anialopata/SMIW/Hardware/plytka.png

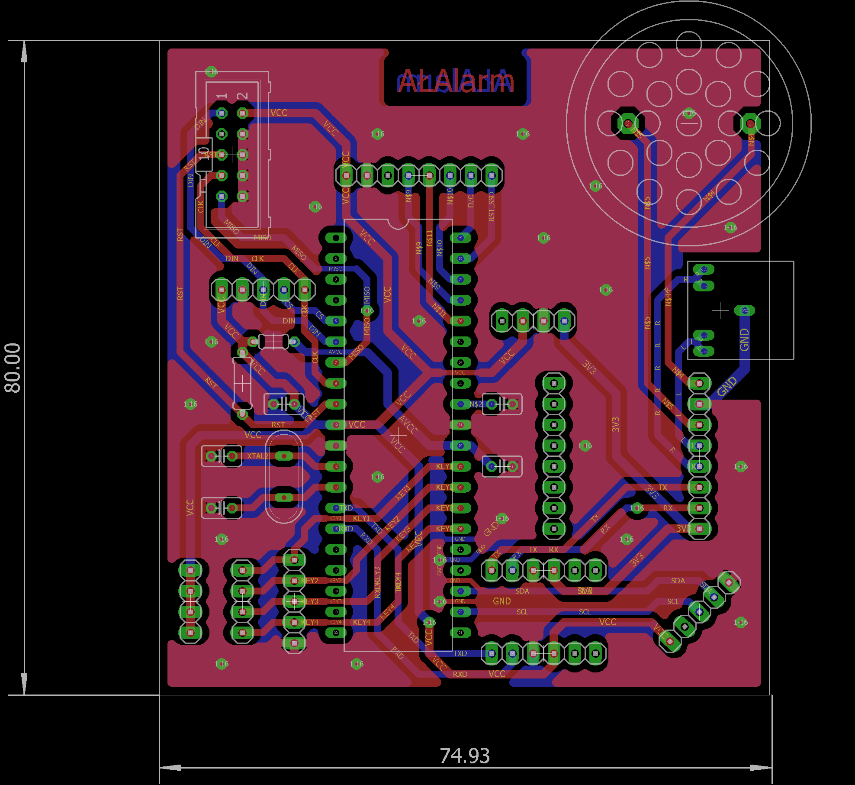
Hardware/plytka.png
