anialopata/SMIW/Hardware/schemat.png

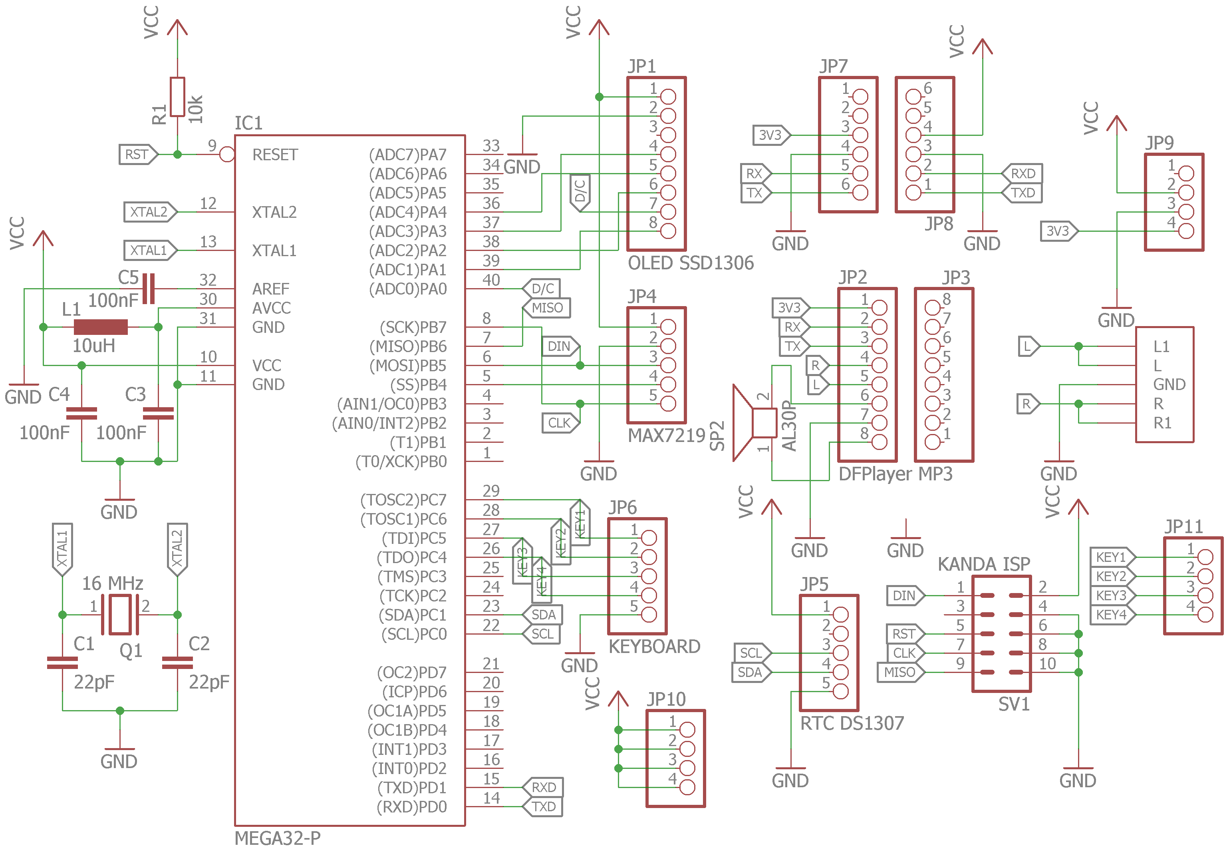
Hardware/schemat.png
