anialopata/SMIW/Utility/kosztorysrev1.xlsx

No | Reference | Description | Price Netto PLN | Qty | Link | Type | Tip
1 | JP2, JP3 | DFPlayer mini odtwarzacz MP3 z gniazdem microSD | 25.12 zł | 1 | https://botland.com.pl/odtwarzacze-mp3-wav-oog-midi/3170-dfplayer-mini-odtwarzacz-mp3-z-gniazdem-microsd.html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 | sterowanie | https://www.dfrobot.com/wiki/index.php/DFPlayer_Mini_SKU:DFR0299#Connection_Diagram
2 | JP1 | Wyświetlacz OLED dwukolorowy graficzny 0,96'' (B) 128x64px SPI/I2C- proste złącza | 28.37 zł | 1 | https://botland.com.pl/wyswietlacze-oled/4437-wyswietlacz-oled-dwukolorowy-graficzny-096-b-128x64px-spii2c-proste-zlacza.html |  | https://github.com/efthymios-ks/AVR-SSD1306-Library
3 | - | Karta pamięci Goodram M1AA microSD 8GB 60MB/s UHS-I klasa 10 z adapterem | 20.28 zł | 1 | https://botland.com.pl/karty-pamieci-microsd-sd/2122-karta-pamieci-goodram-m1aa-microsd-8gb-60mbs-uhs-i-klasa-10-z-adapterem-5908267913277.html
4 | JP5 | MSX RTC DS1307 I2C - zegar czasu rzeczywistego + bateria | 14.55 zł | 1 | https://botland.com.pl/moduly-rtc/2717-msx-rtc-ds1307-i2c-zegar-czasu-rzeczywistego-bateria.html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 |  | http://www.jarzebski.pl/arduino/komponenty/zegar-czasu-rzeczywistego-rtc-ds1307.html
5 | SP1 | Głośnik YD30 0,5W 8Ohm - 15 x 12 mm | 1.95 zł | 1 | https://botland.com.pl/glosniki-analogowe/3469-glosnik-yd30-05w-8ohm-15-x-12-mm.html
6 | JP6 | Klawiatura numeryczna membranowa samoprzylepna - 4 klawisze | 5.28 zł | 1 | https://botland.com.pl/klawiatury/4266-klawiatura-numeryczna-membranowa-samoprzylepna-4-klawisze.html |  | https://botland.com.pl/img/p/3/4/7/6/5/34765.jpg?time=1501065470757
7 | JP4 | Matryca LED 32x8 + sterownik MAX7219 - czerwony | 26.61 zł | 1 | http://allegro.pl/modul-4-matryce-led-8x8-ze-sterownikiem-max7219-i7281989137.html |  | https://adnbr.co.uk/articles/max7219-and-7-segment-displays
8 | IC1 | Mikrokontroler AVR - ATmega32A-PU - DIP | 10.49 zł | 1 | https://botland.com.pl/avr-tht-dip/159-mikrokontroler-avr-atmega32a-pu-dip.html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
9 | Q1 | Rezonator kwarcowy 16MHz - HC49 - niski | 0.57 zł | 1 | https://botland.com.pl/rezonatory/166-rezonator-kwarcowy-16mhz-hc49-niski.html?search_query=kwarc&results=54 | pasywne | http://mikrokontrolery.blogspot.com/2011/04/minimalne-podlaczanie-pinow.html
10 | C3, C4, C5 | Kondensator ceramiczny 100nF/50V THT - 10szt. | 0.80 zł | 1 | https://botland.com.pl/kondensatory-ceramiczne-dip/210-kondensator-ceramiczny-100nf50v-tht-10szt.html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
11 | R1 | Rezystor THT 1/4 W 10kΩ - 30szt. | 1.54 zł | 1 | https://botland.com.pl/rezystory-przewlekane/3967-rezystor-tht-14-w-10k-30-szt.html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
12 | SV1 | Wtyk IDC 10 pin prosty - 5 szt. | 1.63 zł | 1 | https://botland.com.pl/zlacza-idc/191-wtyk-idc-10pin-prosty-5-szt.html?search_query=idc&results=74
13 | L1 | Dławik osiowy przeciwzakłóceniowy 10uH/160mA - 10szt. | 1.63 zł | 1 | https://botland.com.pl/dlawiki/438-dlawik-osiowy-przeciwzakloceniowy-10uh-10szt.html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
14 | C1, C2 | Kondensator ceramiczny 22pF/50V THT - 10 szt. | 0.80 zł | 1 | https://botland.com.pl/kondensatory-ceramiczne-dip/448-kondensator-ceramiczny-22pf50v-tht-10szt.html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
15 | - | Płytka stykowa 830 otworów | 6.42 zł | 1 | https://botland.com.pl/plytki-stykowe/55-plytka-stykowa-830-otworow.html | prototyp
16 | - | Przewody połączeniowe męsko-męskie 20cm - 40szt. | 4.84 zł | 1 | https://botland.com.pl/przewody-polaczeniowe/1223-przewody-polaczeniowe-mesko-meskie-20cm-40szt.html
17 | - | Przejściówka kanda ISP 6 PIN - ISP 10 PIN | 3.98 zł | 1 | https://botland.com.pl/programatory/1688-przejsciowka-kanda-isp-6-pin-isp-10-pin.html |  | https://www.google.pl/search?q=kanda+isp&tbm=isch&biw=1680&bih=944
18 | - | Programator USB AVR Pololu v2 - microUSB 3,3V/5V | 35.77 zł | 1 | https://botland.com.pl/programatory/5720-programator-avr-2-zgodny-z-usbasp-isp.html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 |  | https://www.pololu.com/product/3170 | podłączany przez przejściówkę (16) do SV1 w celu programowania układu
19 | - | Drukowanie płytki PCB | 26.09 zł | 1 | http://fabrykapcb.pl/kalkulator.html | usługi
 |  |  |  | 216.73 zł
