anialopata/SMIW/Utility/Logic_level_converter.pdf

A

A

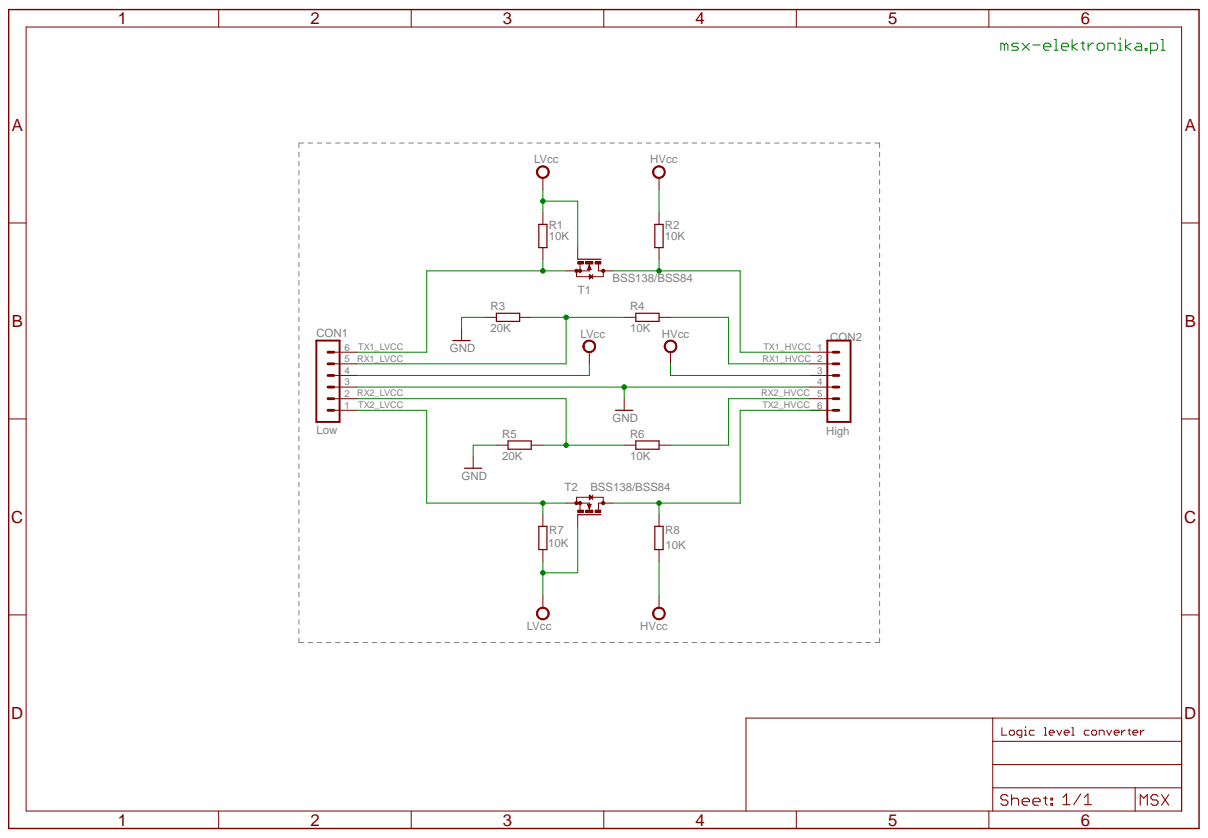
[picture p3: page 1]
