anialopata/SMIW/Hardware/plytka.brd

## EAGLE design Hardware/plytka.brd (2018-09-09)

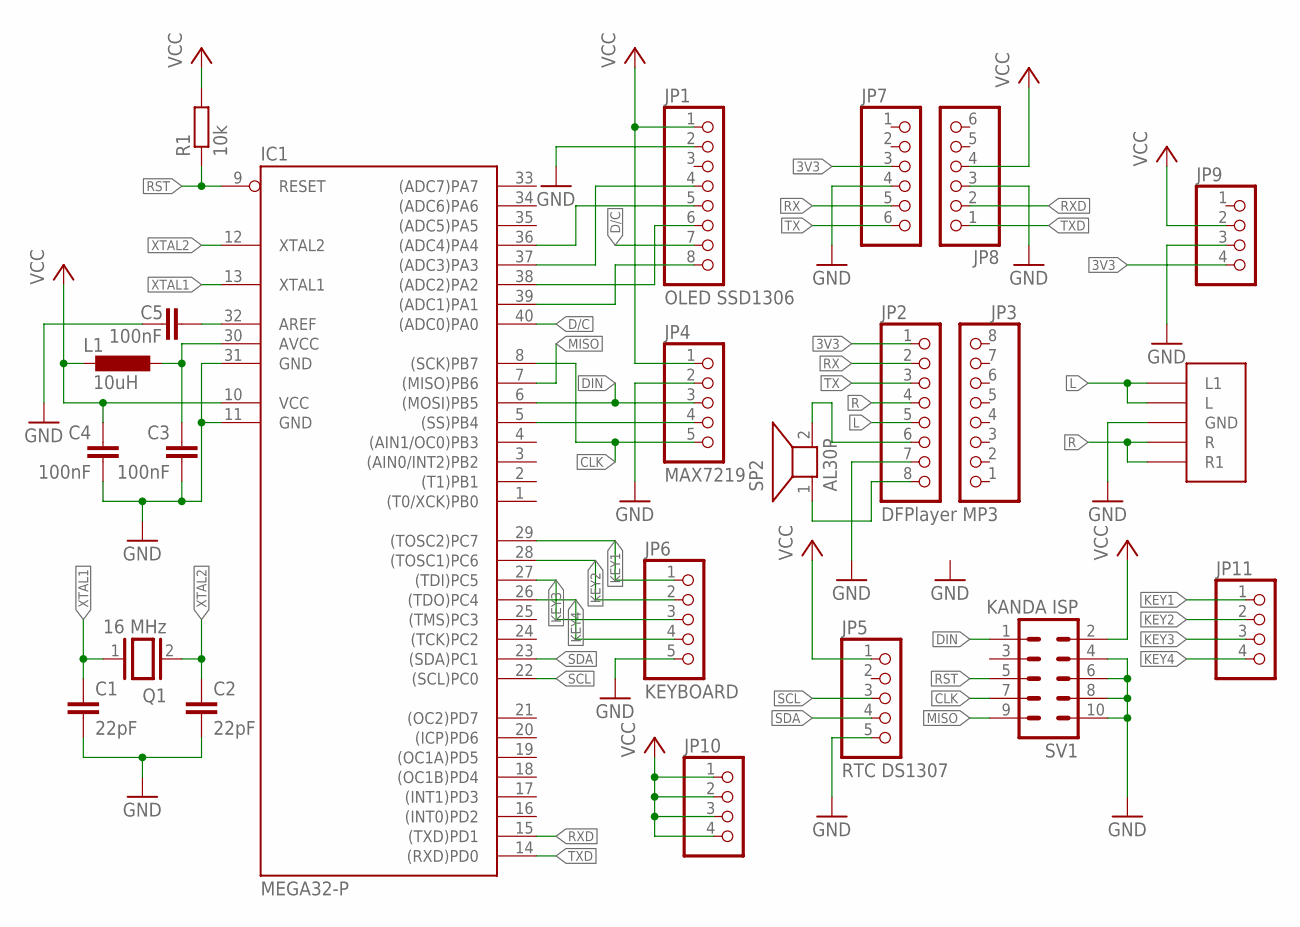
[picture p4: schematic schemat.sch]

Parts:
C1, C2: 22pF; C025-025X050
C3, C4, C5: 100nF; C025-025X050
IC1: MEGA32-P; DIL40
JP1: OLED SSD1306; 1X08
JP2: DFPlayer MP3; 1X08
JP3: 1X08
JP4: MAX7219; 1X05
JP5: RTC DS1307; 1X05
JP6: KEYBOARD; 1X05
JP7, JP8: PINHD-1X6; 1X06
JP9, JP10, JP11: PINHD-1X4; 1X04
L1: 10uH; 0204/5
Q1: 16 MHz; QS
R1: 10k; 0207/7
SP2: AL30P
SV1: KANDA ISP; ML10
U$1: STEREO_D; STEREO_P

Connections:
3V3: JP2.1, JP7.3, JP9.4
AVCC: C3.1, IC1.30 (AVCC), L1.1
CLK: IC1.8 ((SCK)PB7), JP4.5, SV1.7
CS: IC1.5 ((SS)PB4), JP4.4
D/C: IC1.40 ((ADC0)PA0), JP1.7
DIN: IC1.6 ((MOSI)PB5), JP4.3, SV1.1
GND: C1.2, C2.2, C3.2, C4.2, C5.2, IC1.11 (GND), IC1.31 (GND), JP1.2, JP2.7, JP4.2, JP5.5, JP6.5, JP7.4, JP8.3, JP9.3, SV1.4, SV1.6, SV1.8, SV1.10, U$1.GND
KEY1: IC1.29 ((TOSC2)PC7), JP6.1, JP11.1
KEY2: IC1.28 ((TOSC1)PC6), JP6.2, JP11.2
KEY3: IC1.27 ((TDI)PC5), JP6.3, JP11.3
KEY4: IC1.26 ((TDO)PC4), JP6.4, JP11.4
L: JP2.5, U$1.L_A (L1), U$1.L_B (L)
MISO: IC1.7 ((MISO)PB6), SV1.9
unnamed: C5.1, IC1.32 (AREF)
unnamed: JP2.8, SP2.1
unnamed: JP2.6, SP2.2
unnamed: IC1.37 ((ADC3)PA3), JP1.4
unnamed: IC1.38 ((ADC2)PA2), JP1.6
unnamed: IC1.36 ((ADC4)PA4), JP1.5
R: JP2.4, U$1.R_A (R1), U$1.R_B (R)
RST: IC1.9 (RESET), R1.1, SV1.5
RST_SSD: IC1.39 ((ADC1)PA1), JP1.8
RX: JP2.2, JP7.5
RXD: IC1.15 ((TXD)PD1), JP8.2
SCL: IC1.22 ((SCL)PC0), JP5.3
SDA: IC1.23 ((SDA)PC1), JP5.4
TX: JP2.3, JP7.6
TXD: IC1.14 ((RXD)PD0), JP8.1
VCC: C4.1, IC1.10 (VCC), JP1.1, JP4.1, JP5.1, JP8.4, JP9.2, JP10.1, JP10.2, JP10.3, JP10.4, L1.2, R1.2, SV1.2
XTAL1: C1.1, IC1.13 (XTAL1), Q1.1
XTAL2: C2.1, IC1.12 (XTAL2), Q1.2

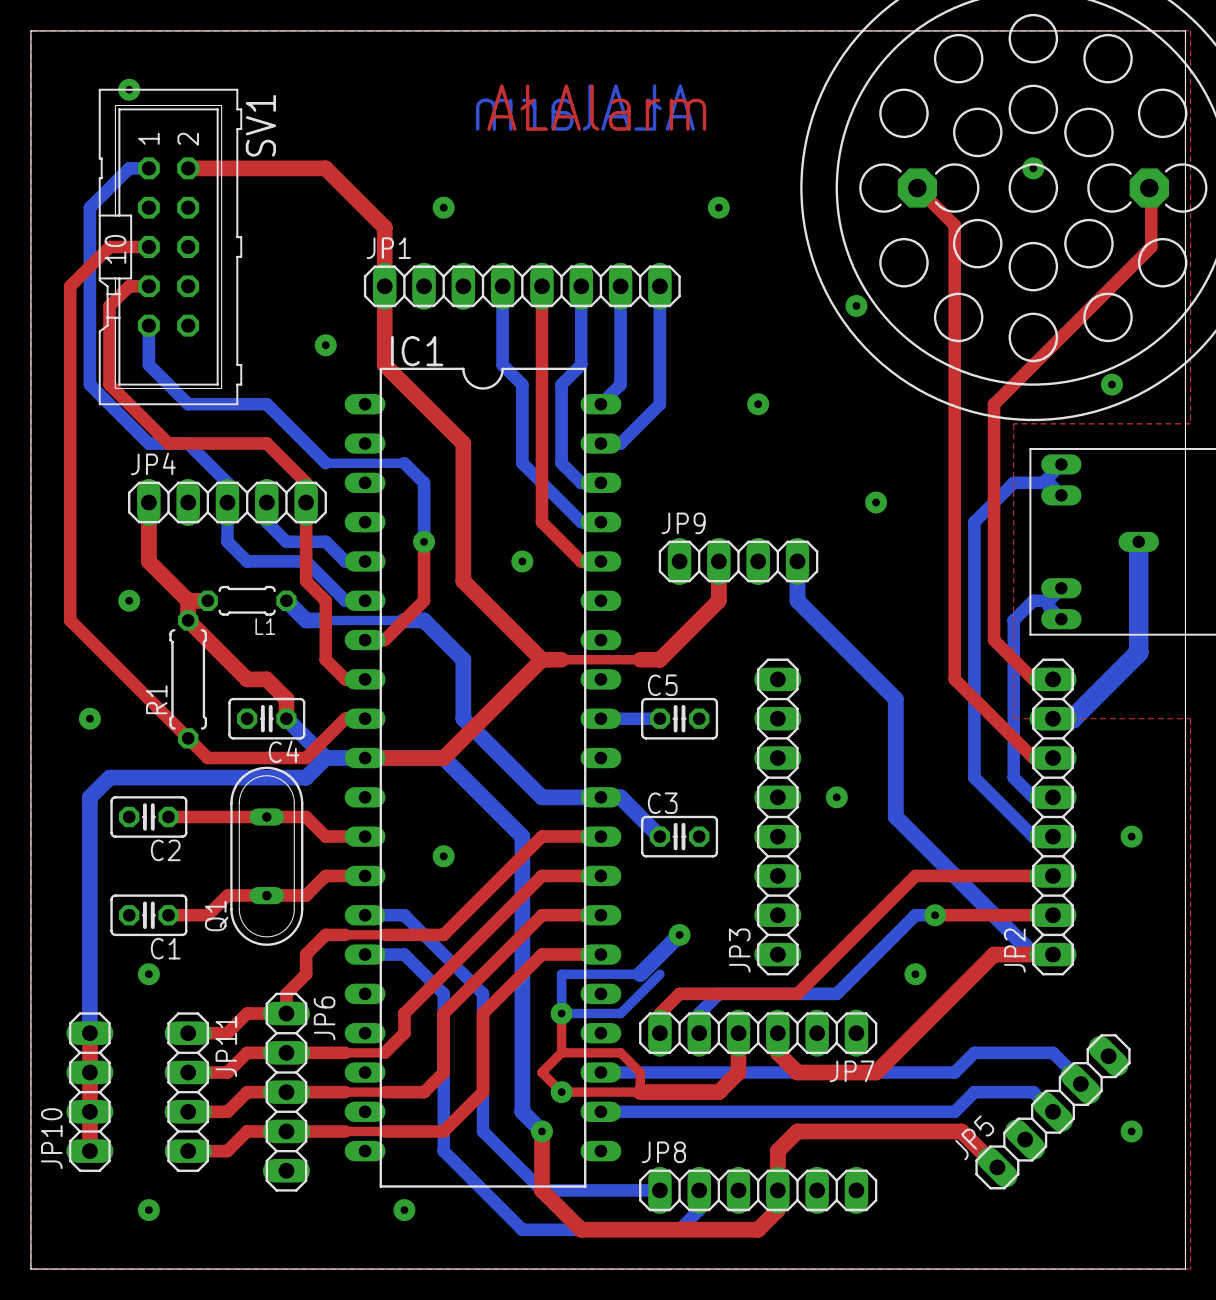
[picture p5: board plytka.brd from above]

Board: 2 copper layers, 74.6 x 80.0 mm, 23 parts (0 on the bottom side), 31 nets.
